samo4/MP2-DFN-OneThird/Kicad_Project/DXFs/MP2_DFN_busbars3.dxf

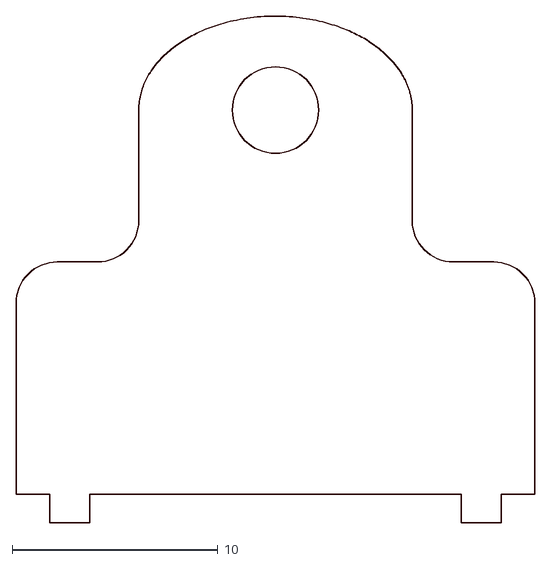
[picture p1: CAD file, 2023-11-18]
Kicad_Project/DXFs/MP2_DFN_busbars3.dxf
25.2 x 24.6
