samo4/MP2-DFN-OneThird/Kicad_Project/NVMTSC4D3N15MC/3D/NVMTSC4D3N15MC.stp

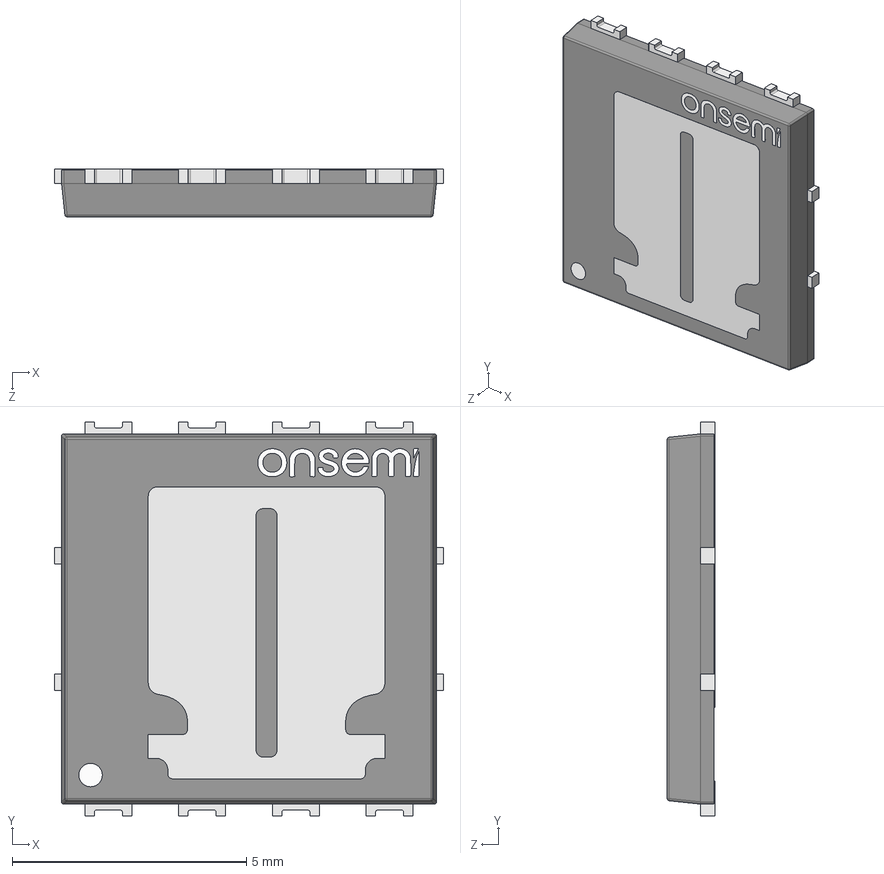
[picture p2: CAD file, 2023-08-23]
Kicad_Project/NVMTSC4D3N15MC/3D/NVMTSC4D3N15MC.stp
8.30 x 8.40 x 1.02 mm
Pins
Top tab
Onsemi Updated Logo
0.5mm
