samo4/MP2-DFN-OneThird/Kicad_Project/DXFs/MP2_DFN_busbars1.dxf

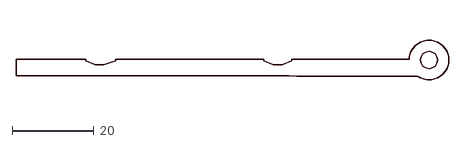
[picture p3: CAD file, 2023-11-18]
Kicad_Project/DXFs/MP2_DFN_busbars1.dxf
105.7 x 9.69
