samo4/MP2-DFN-OneThird/Kicad_Project/DXFs/MP2_DFN_busbars4.dxf

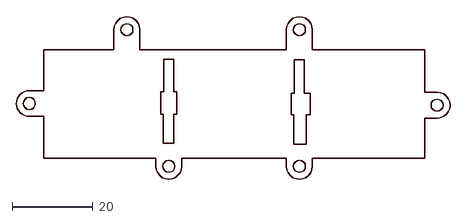
[picture p5: CAD file, 2023-11-18]
Kicad_Project/DXFs/MP2_DFN_busbars4.dxf
107.2 x 40.4
