samo4/MP2-DFN-OneThird/Kicad_Project/MP2_DFN.pdf

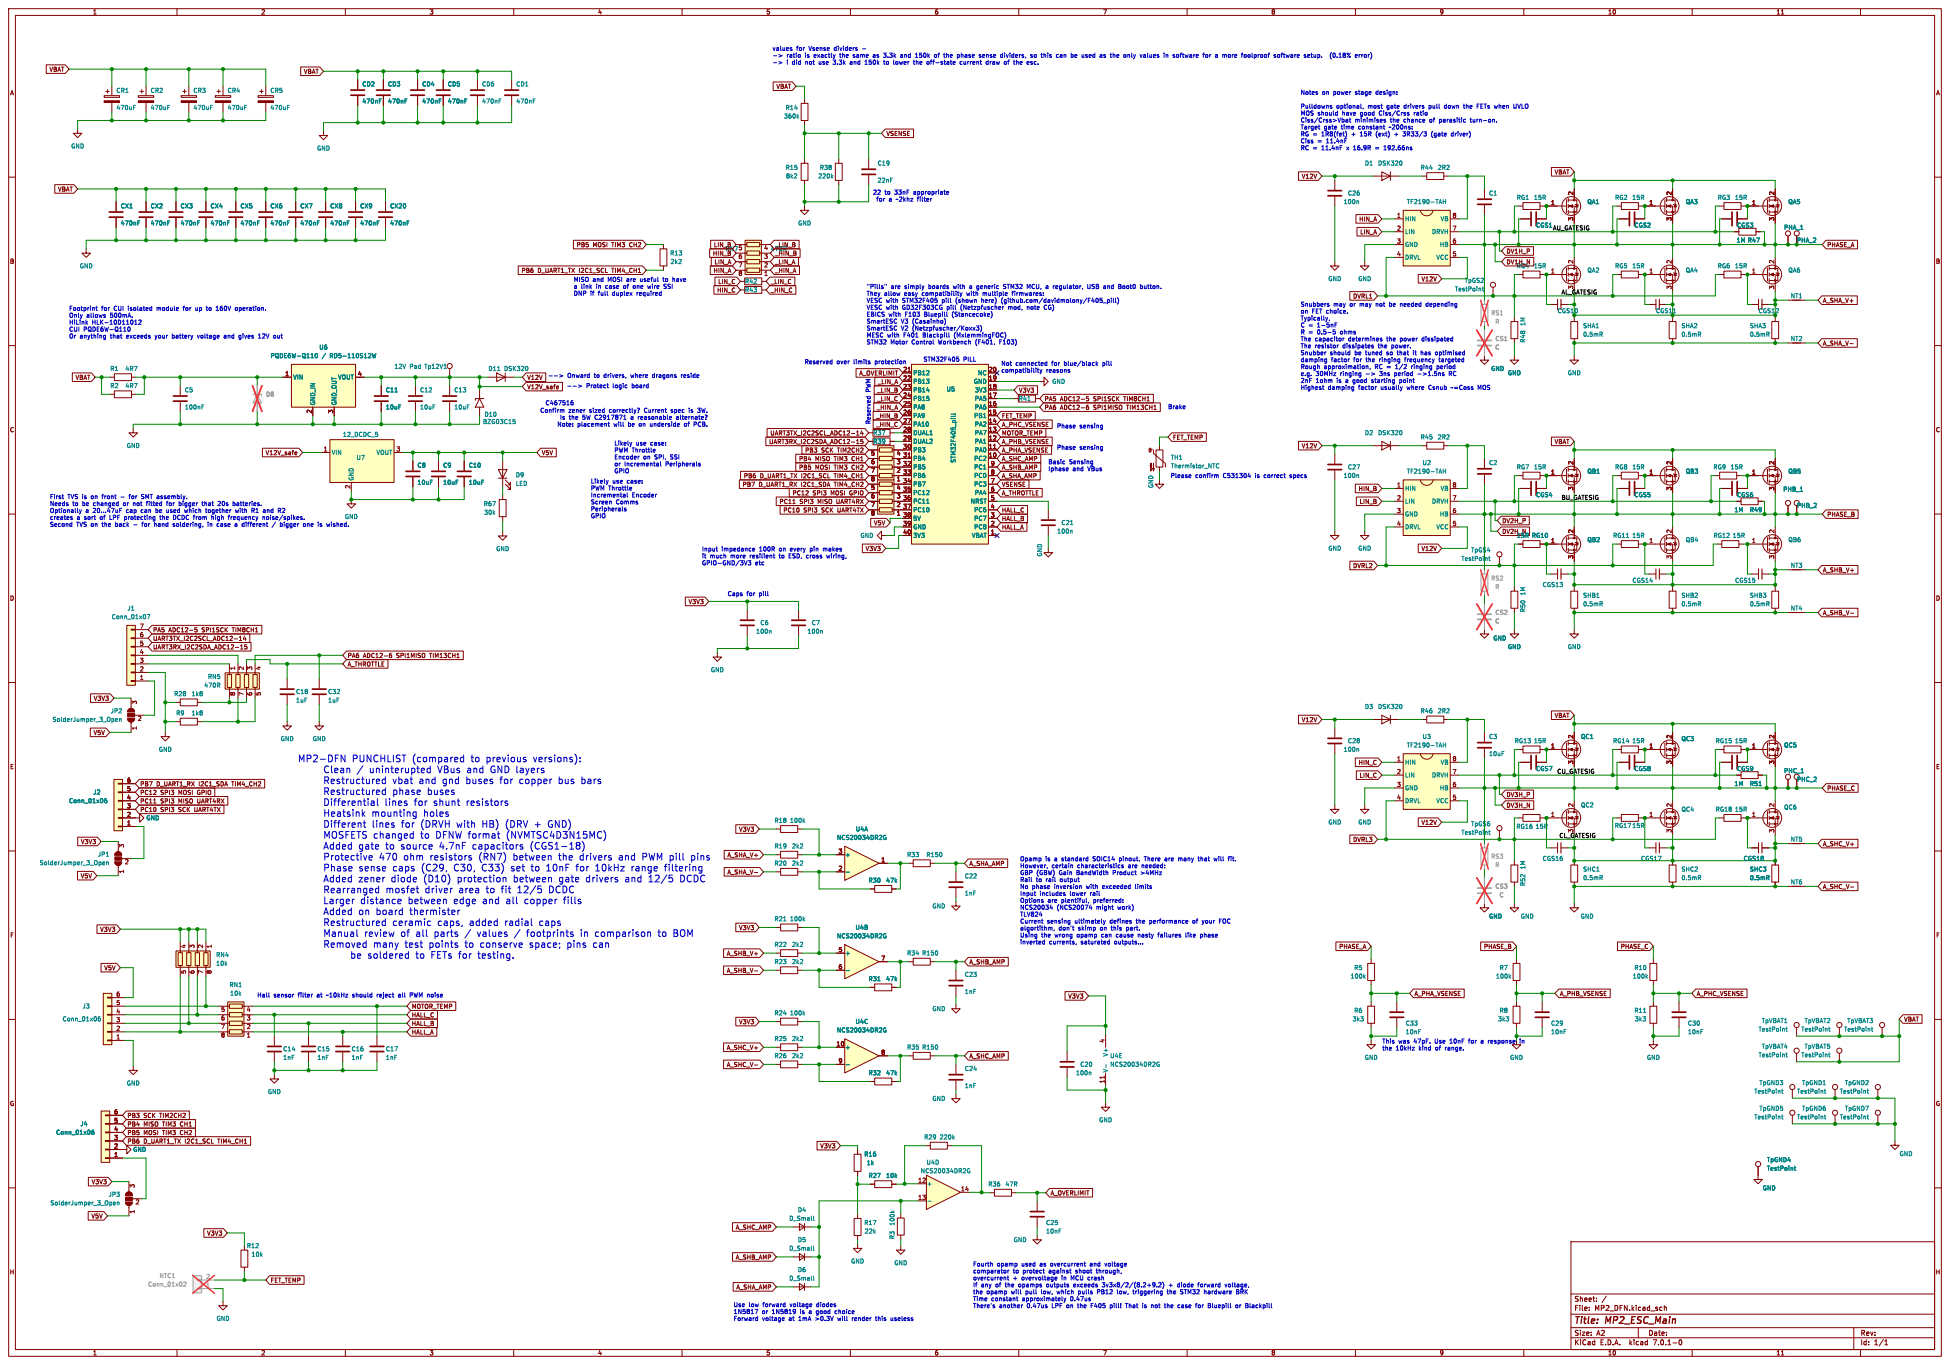
[picture p6: page 1]

values for Vsense dividers -

MISO and MOSI are useful to have

Only allows 500mA. HiLink HLK-10D11012 CUI PQDE6W-Q110 Or anything that exceeds your battery voltage and gives 12V out

Reserved over limits protection

Likely use case: PWM Throttle

This was 47pF. Use 10nF for a response in

Use low forward voltage diodes 1N5817 or 1N5819 is a good choice Forward voltage at 1mA >0.3V will render this useless
