samo4/MP2-DFN-OneThird/(commit log)

2023-08-13 initial layout approach
    [CCC_ESC.kicad_sch]
2023-08-15 general layout complete
    [CCC_ESC.kicad_pcb]
2023-08-16 reversed side of bus bars
    [CCC_ESC.kicad_pcb, CCC_ESC.kicad_sch]
2023-08-18 added in resistors, gate/source caps
    [CCC_ESC.kicad_pcb, CCC_ESC.kicad_sch]
2023-08-19 first draft
    [CCC_ESC.kicad_pcb, CCC_ESC.kicad_sch]
2023-08-20 added bootstrap resistors
    [CCC_ESC.kicad_sch]
2023-08-21 more layout
    [CCC_ESC.kicad_sch]
2023-08-22 added thermistor, 12v zener
    [CCC_ESC.kicad_pcb, CCC_ESC.kicad_sch]
2023-08-23 added docs, prettied up fills
    [CCC_ESC.kicad_pcb, CCC_ESC.kicad_sch]
2023-08-23 added docs, prettied up fills, fix FET footprint
    [NVMTSC4D3N15MC.stp]
2023-08-24 new DFN footprints, changed some routes
    [CCC_ESC.kicad_pcb, CCC_ESC.kicad_sch]
2023-08-24 minor touchups
    [CCC_ESC.kicad_pcb]
2023-08-25 second draft ready for review
    [CCC_ESC.kicad_pcb, CCC_ESC.kicad_sch]
2023-08-27 fixed most of DMs suggestions
    [CCC_ESC.kicad_pcb, CCC_ESC.kicad_sch]
2023-08-28 changed all file names
    [MP2_DFN.kicad_pcb, MP2_DFN.kicad_sch]
2023-08-30 created manufacturing files
    [MP2_DFN-B_Cu.gbr, MP2_DFN-B_Mask.gbr, MP2_DFN-B_Paste.gbr, MP2_DFN-B_Silkscreen.gbr, MP2_DFN-Edge_Cuts.gbr, MP2_DFN-F_Cu.gbr, MP2_DFN-F_Mask.gbr, MP2_DFN-F_Paste.gbr]
2023-08-30 order sent to jlcpcb
    [MP2_DFN-B_Cu.gbr, MP2_DFN-B_Mask.gbr, MP2_DFN-B_Paste.gbr, MP2_DFN-B_Silkscreen.gbr, MP2_DFN-Edge_Cuts.gbr, MP2_DFN-F_Cu.gbr, MP2_DFN-F_Mask.gbr, MP2_DFN-F_Paste.gbr]
2023-09-21 fixed GND breaks, increased bus bars
    [MP2_DFN.kicad_sch]
2023-09-25 removed some caps between phase connectors
2023-09-25 added caps, prettied up phase connectors
    [MP2_DFN.kicad_sch]
2023-09-27 micro adjustments to heatsink holes
2023-10-04 changed schematic to F405 pill, cleanup on vias/tracks
    [MP2_DFN.kicad_sch]
2023-10-04 added correct F405 pill --> connector names
    [MP2_DFN.kicad_pcb]
2023-10-06 flipped placement of larger parts to bottom side
    [MP2_DFN.kicad_pcb]
2023-10-19 using JLC plugin to manage rotations
    [MP2_DFN.kicad_sch, bom.csv, designators.csv, positions.csv]
2023-10-23 changes from MP2 v0.6 i think it is now, readded some parts to the pcb, and fixed some minor tidyness thingies
    [MP2_DFN.kicad_sch]
2023-10-27 V0.2 JLCPCB order 12/26/23
    [MP2_DFN.kicad_sch, MP2_DFN_BOM.xlsx, bom.csv, designators.csv, positions.csv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]
2023-11-18 ES release
    [MP2_DFN-B_Cu.gbr, MP2_DFN-B_Mask.gbr, MP2_DFN-B_Paste.gbr, MP2_DFN-B_SilkS.gbr, MP2_DFN-B_Silkscreen.gbr, MP2_DFN-Edge_Cuts.gbr, MP2_DFN-F_Cu.gbr, MP2_DFN-F_Mask.gbr]
2023-11-26 changed phase voltage sense dividers to 150-3.3 - as it should hav beeen
    [MP2_DFN.kicad_sch]
